aashaar/IoT-Project-Home-Security/diagrams and pics/Architecture & Sequence Diagram pic.jpg

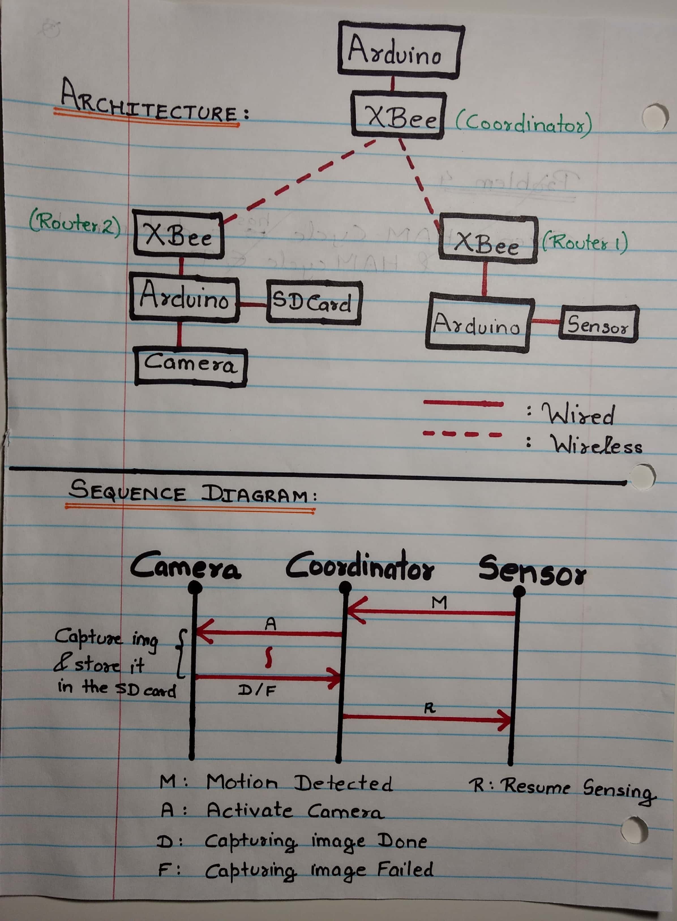
diagrams and pics/Architecture & Sequence Diagram pic.jpg
