aashaar/IoT-Project-Home-Security/README.md

This project is an implementation of an 'Automated Home Security System' in the domain of Internet of Things (IoT). Please refer the project report (IoT Project Final Report.pdf) for more details.
The code for prototype is present in the folder 'Prototype code' & the code for enhanced version is present in the folder 'Enhanced Pi Camera code'.
Please visit https://www.youtube.com/channel/UCbG3AGvjXvx3UoMn_Qty89Q to see live demos and understand the intricate details that I explored while working on this.
