aashaar/IoT-Project-Home-Security/(commit log)

2018-10-30 Completed Phase 2 :Router is sending PIR sensor's data to Coordinator
2018-11-01 added toggle button to turn on system
2018-11-01 Phase 3- arduino nano version added- success
2018-12-10 Final working arduino code
2018-12-10 prototype project report draft added. Copied final codes in two new folders - Prototype Code & Enchanced Pi Camera code
2018-12-11 prototype documentation draft done
2018-12-12 added pin connections in doc
2018-12-12 add camera name
2019-06-28 added You tube channel's link to the readme file
